deved9/Sat_beacon/BOM.ods

BOM
 |  |  |  | TOTAL: | 1010.757
CAPACITOR
val | Qty | link | price per one |  | total
100n | 25 | https://www.tme.eu/cz/details/0603b104k250ct/kondenzatory-mlcc-smd/walsin/ | 0.295 |  | 7.375 |  | Pro zápis do online tabulky:
4.7u | 27 | https://www.tme.eu/cz/details/cl21b475kafnnne/kondenzatory-mlcc-smd/samsung/ | 1.85 |  | 49.95
2.2u | 6 | https://www.tme.eu/cz/details/grm188r61e225ka12d/kondenzatory-mlcc-smd/murata/ | 0.737 |  | 4.422
10u | 10 | https://www.tme.eu/cz/details/grm188r61e106ka73d/kondenzatory-mlcc-smd/murata/ | 1.186 |  | 11.86 | C 100n | https://www.tme.eu/cz/details/0603b104k250ct/kondenzatory-mlcc-smd/walsin/ | 0,295 | 25 | Maňásek | Wed 8:00 | Mám k dispozici CSV soubory jak na Digikey tak TME. Můžu dodat pro ulehčení
22u | 6 | https://www.tme.eu/cz/details/cl21a226maynnne/kondenzatory-mlcc-smd/samsung/ | 1.417 |  | 8.502 | C 4.7u | https://www.tme.eu/cz/details/cl21b475kafnnne/kondenzatory-mlcc-smd/samsung/ | 1,85 | 27 | Maňásek | Wed 8:00
5.6n | 4 | https://www.digikey.cz/cs/products/detail/murata-electronics/GRT1885C1E562JA02D/10705377 | 2.03 |  | 8.12 | C 2.2u | https://www.tme.eu/cz/details/grm188r61e225ka12d/kondenzatory-mlcc-smd/murata/ | 0,737 | 6 | Maňásek | Wed 8:00
33n | 4 | https://www.tme.eu/cz/details/c0603c333k3rac/kondenzatory-mlcc-smd/kemet/c0603c333k3ractu/ | 1.25 |  | 5 | C 10u | https://www.tme.eu/cz/details/grm188r61e106ka73d/kondenzatory-mlcc-smd/murata/ | 1,186 | 10 | Maňásek | Wed 8:00
47p | 10 | https://www.tme.eu/cz/details/gjm1555c1h470jb01d/kondenzatory-mlcc-smd/murata/ | 1.017 |  | 10.17 | C 22u | https://www.tme.eu/cz/details/cl21a226maynnne/kondenzatory-mlcc-smd/samsung/ | 1,417 | 6 | Maňásek | Wed 8:00
13p | 10 | https://www.tme.eu/cz/details/gjm1555c1h130gb01d/kondenzatory-mlcc-smd/murata/ | 1.064 |  | 10.64 | C 5.6n | https://www.digikey.cz/cs/products/detail/murata-electronics/GRT1885C1E562JA02D/10705377 | 2,03 | 4 | Maňásek | Wed 8:00
 |  |  |  |  |  | C 33n | https://www.tme.eu/cz/details/c0603c333k3rac/kondenzatory-mlcc-smd/kemet/c0603c333k3ractu/ | 1,25 | 4 | Maňásek | Wed 8:00
LED |  |  |  |  |  | C 47p | https://www.tme.eu/cz/details/gjm1555c1h470jb01d/kondenzatory-mlcc-smd/murata/ | 1,017 | 10 | Maňásek | Wed 8:00
green | 6 | https://www.tme.eu/cz/details/rf-tgb190ts-ca-p1/diody-led-smd-barevne/refond/ | 2.54 |  | 15.24 | C 13p | https://www.tme.eu/cz/details/gjm1555c1h130gb01d/kondenzatory-mlcc-smd/murata/ | 1,064 | 10 | Maňásek | Wed 8:00
 |  |  |  |  |  | green LED | https://www.tme.eu/cz/details/rf-tgb190ts-ca-p1/diody-led-smd-barevne/refond/ | 2,54 | 6 | Maňásek | Wed 8:00
PLL |  |  |  |  |  | PLL LMX2581 | https://www.digikey.cz/cs/products/detail/texas-instruments/LMX2581SQE-NOPB/3727320 | 335,93 | 2 | Maňásek | Wed 8:00
LMX2581 | 2 | https://www.digikey.cz/cs/products/detail/texas-instruments/LMX2581SQE-NOPB/3727320 | 335.93 |  | 671.86 | L 18n | https://www.tme.eu/cz/details/lqg18hn18nj00d/tlumivky/murata/ | 2,59 | 6 | Maňásek | Wed 8:00
 |  |  |  |  |  | NPN BC817-40 | https://www.digikey.cz/cs/products/detail/diotec-semiconductor/BC817-40/13163902 | 2,84 | 10 | Maňásek | Wed 8:00
Inductor |  |  |  |  |  | R 1k | https://www.tme.eu/cz/details/rc0603fr-071k/rezistory-smd/yageo/rc0603fr-071kl/ | 0,46 | 10 | Maňásek | Wed 8:00
18n | 6 | https://www.tme.eu/cz/details/lqg18hn18nj00d/tlumivky/murata/ | 2.59 |  | 15.54 | R 51R | https://www.tme.eu/cz/details/wr06x51r0ftl/rezistory-smd/walsin/ | 0,27 | 10 | Maňásek | Wed 8:00
 |  |  |  |  |  | R 560R – 1206 | https://www.tme.eu/cz/details/rc1206fr-07560r/rezistory-smd/yageo/rc1206fr-07560rl/ | 1,108 | 6 | Maňásek | Wed 8:00
NPN |  |  |  |  |  | R 220k | https://www.tme.eu/cz/details/rc0603fr-07220k/rezistory-smd/yageo/rc0603fr-07220kl/ | 0,145 | 10 | Maňásek | Wed 8:00
BC817-40 | 10 | https://www.digikey.cz/cs/products/detail/diotec-semiconductor/BC817-40/13163902 | 2.84 |  | 28.4 | R 560R – 0603 | https://www.tme.eu/cz/details/rc0603fr-07560r/rezistory-smd/yageo/rc0603fr-07560rl/ | 0,19 | 10 | Maňásek | Wed 8:00
 |  |  |  |  |  | R 0R | https://www.tme.eu/cz/details/rc0603jr-070r/rezistory-smd/yageo/rc0603jr-070rl/ | 0,46 | 10 | Maňásek | Wed 8:00
Resistor |  |  |  |  |  | BTN | https://www.tme.eu/cz/details/b3fs-1015/mikrospinace-tact/omron-electronic-components/ | 7,37 | 4 | Maňásek | Wed 8:00
1k | 10 | https://www.tme.eu/cz/details/rc0603fr-071k/rezistory-smd/yageo/rc0603fr-071kl/ | 0.46 |  | 4.6 | MCU STM32C011F6Px | https://www.digikey.cz/cs/products/detail/stmicroelectronics/STM32C011F6P6TR/18085144 | 18,48 | 1 | Maňásek | Wed 8:00
51R | 10 | https://www.tme.eu/cz/details/wr06x51r0ftl/rezistory-smd/walsin/ | 0.27 |  | 2.7 | LDO LD1117V33 | https://www.digikey.cz/cs/products/detail/stmicroelectronics/LD1117DT33CTR/585759 | 8,12 | 5 | Maňásek | Wed 8:00
560R – 1206 | 6 | https://www.tme.eu/cz/details/rc1206fr-07560r/rezistory-smd/yageo/rc1206fr-07560rl/ | 1.108 |  | 6.648 | Balun 1720BL15B0050002E | https://www.digikey.cz/cs/products/detail/johanson-technology-inc/1720BL15B0050001E/5980443 | 6,91 | 2 | Maňásek | Wed 8:00
220k | 10 | https://www.tme.eu/cz/details/rc0603fr-07220k/rezistory-smd/yageo/rc0603fr-07220kl/ | 0.145 |  | 1.45 | TCXO FT2MHUPM10.0-T1 | https://www.digikey.cz/cs/products/detail/fox-electronics/FT2MHUPM10-0-T1/22155822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 | 39,4 | 1 | Maňásek | Wed 8:00
560R – 0603 | 10 | https://www.tme.eu/cz/details/rc0603fr-07560r/rezistory-smd/yageo/rc0603fr-07560rl/ | 0.19 |  | 1.9
0R | 10 | https://www.tme.eu/cz/details/rc0603jr-070r/rezistory-smd/yageo/rc0603jr-070rl/ | 0.46 |  | 4.6 | RF LNA | https://www.digikey.cz/cs/products/detail/texas-instruments/TRF37D73IDSGR/6572565 | 28,03 | 2 | Maňásek | Wed 8:00 | Soukromý nákup dle předchozí domluvy
 |  |  |  |  |  | LNB Controller | https://www.digikey.cz/cs/products/detail/richtek-usa-inc/RT5047BFGSP/8573230 | 29,45 | 2 | Maňásek | Wed 8:00
SW/BTN
power sw | 1 | vezmu to v GME, nevleze se do rozpočtu + moc není co vybírat |  |  | 0
BTN | 4 | https://www.tme.eu/cz/details/b3fs-1015/mikrospinace-tact/omron-electronic-components/ | 7.37 |  | 29.48
MCU
STM32C011F6Px | 1 | https://www.digikey.cz/cs/products/detail/stmicroelectronics/STM32C011F6P6TR/18085144 | 18.48 |  | 18.48
LDO
LD1117V33 | 5 | https://www.digikey.cz/cs/products/detail/stmicroelectronics/LD1117DT33CTR/585759 | 8.12 |  | 40.6
Balun
1720BL15B0050002E | 2 | https://www.digikey.cz/cs/products/detail/johanson-technology-inc/1720BL15B0050001E/5980443 | 6.91 |  | 13.82
FT2MHUPM10.0-T1 | 1 | https://www.digikey.cz/cs/products/detail/fox-electronics/FT2MHUPM10-0-T1/22155822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 | 39.4 |  | 39.4
