deved9/Sat_beacon/Sat_beacon.kicad_pcb

## KiCad design Sat_beacon.kicad_pcb (2026-05-11)

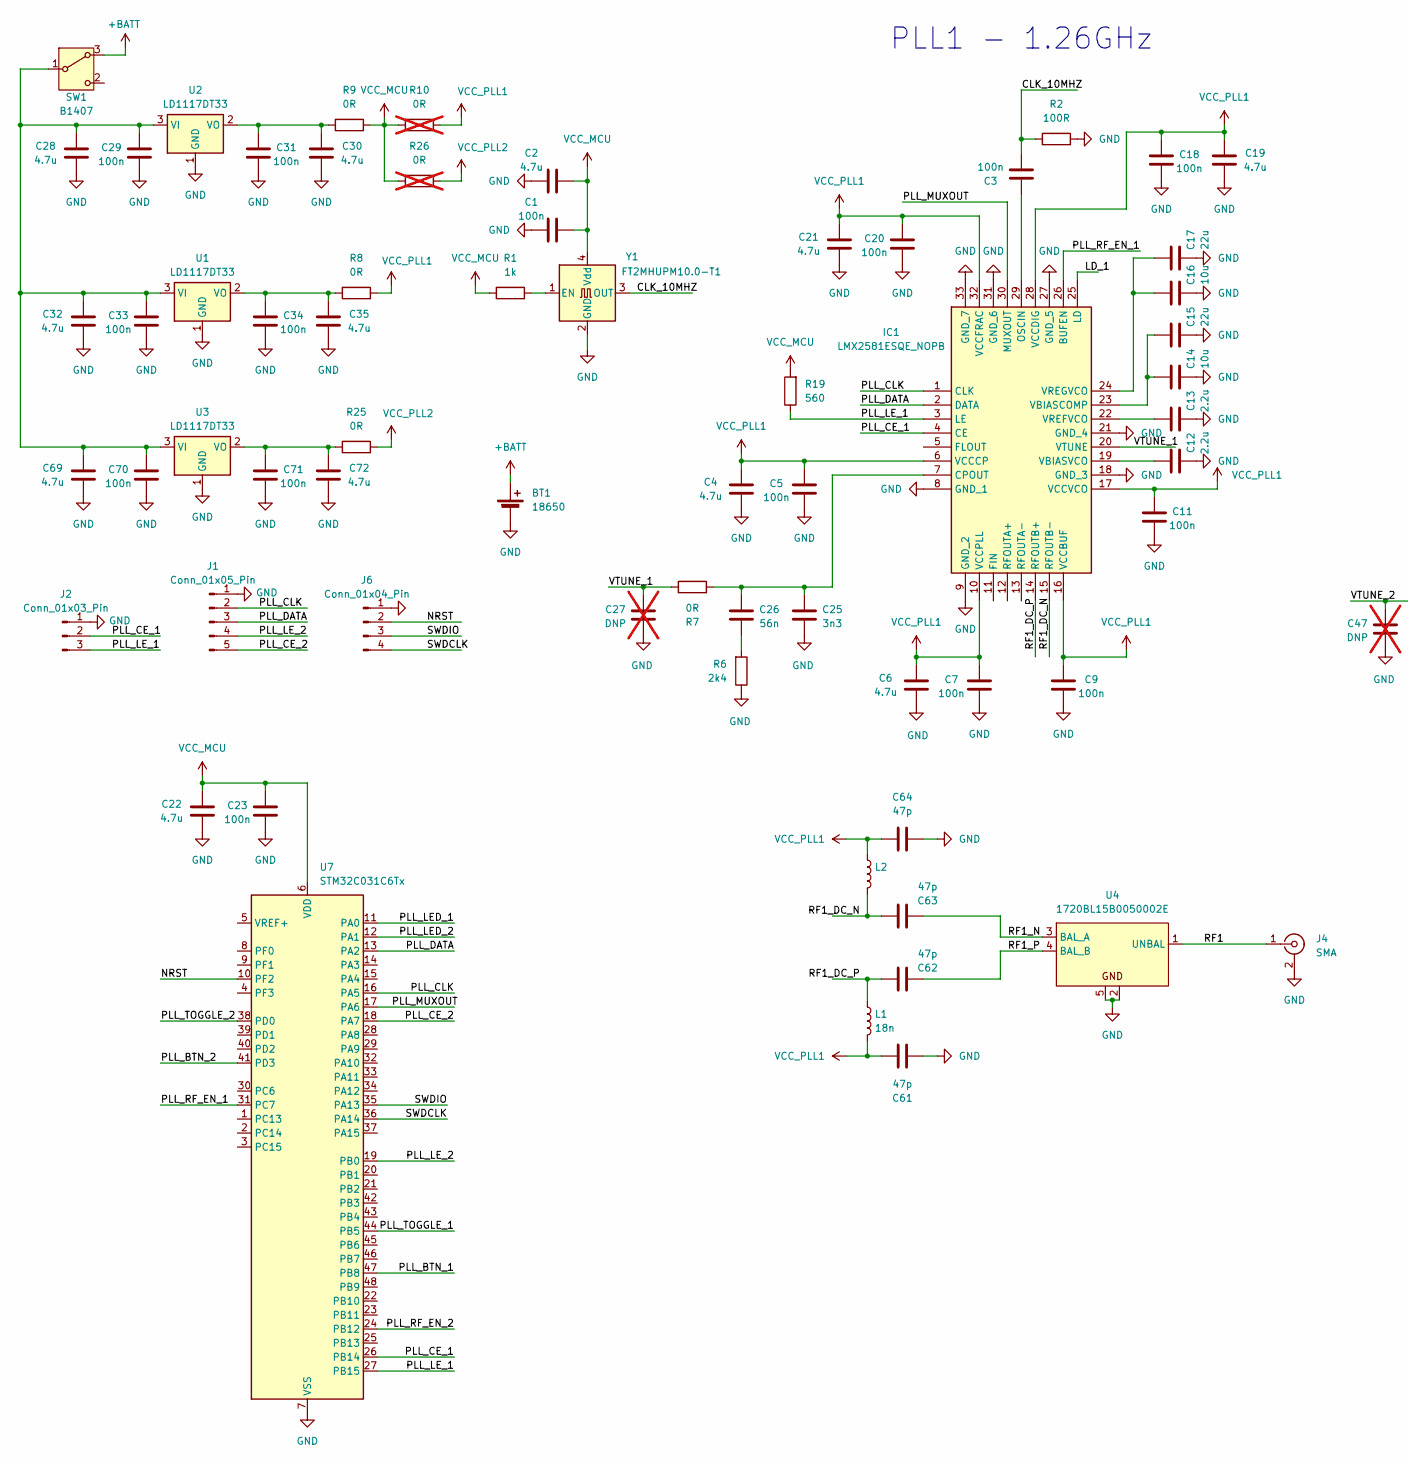
[picture p1: schematic Sat_beacon.kicad_sch, part in row 1, column 1]

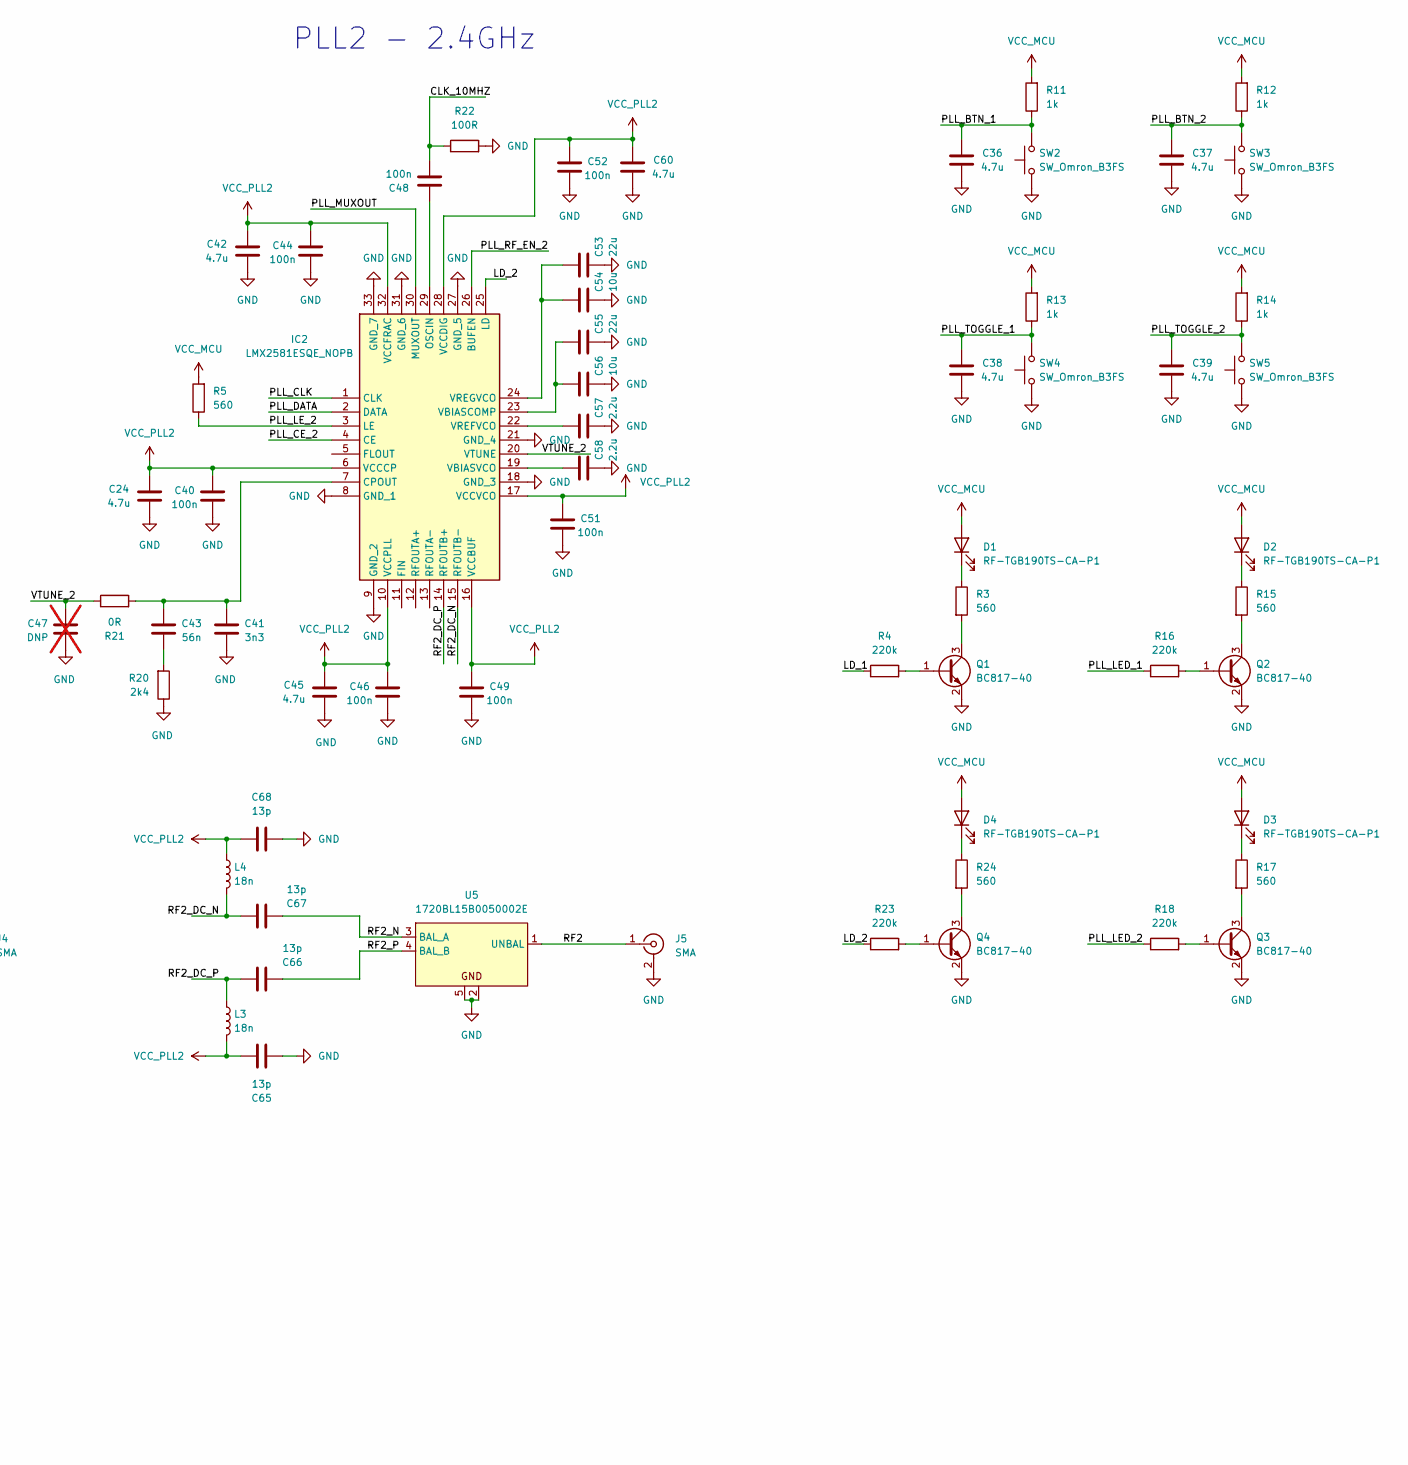
[picture p2: schematic Sat_beacon.kicad_sch, part in row 1, column 2]

Parts:
BT1: 18650; BatteryHolder_MPD_BH-18650-PC
C1, C3, C5, C7, C9, C11, C18, C20, C23, C29, C31, C33, C34, C40, C44, C46, C48, C49, C51, C52, C70, C71: 100n; C_0603_1608Metric
C2, C4, C6, C19, C21, C22, C24, C28, C30, C32, C35, C36, C37, C38, C39, C42, C45, C60, C69, C72: 4.7u; C_0805_2012Metric
C12, C13, C57, C58: 2.2u; C_0603_1608Metric
C14, C16, C54, C56: 10u; C_0603_1608Metric
C15, C17, C53, C55: 22u; C_0805_2012Metric
C25, C41: 3n3; C_0603_1608Metric
C26, C43: 56n; C_0603_1608Metric
C27, C47: DNP; C_0603_1608Metric; not fitted
C61, C62, C63, C64: 47p; C_0402_1005Metric
C65, C66, C67, C68: 13p; C_0402_1005Metric
D1, D2, D3, D4: RF-TGB190TS-CA-P1; LED_0603_1608Metric
IC1, IC2: LMX2581ESQE_NOPB; QFN50P500X500X80-33M; Mouser Part Number 595-LMX2581ESQE/NOPB
J1: Conn_01x05_Pin; PinHeader_1x05_P2.54mm_Vertical
J2: Conn_01x03_Pin; PinHeader_1x03_P2.54mm_Vertical
J4, J5: SMA; SMA_Amphenol_132289_EdgeMount
J6: Conn_01x04_Pin; PinHeader_1x04_P2.54mm_Vertical
L1, L2, L3, L4: 18n; L_0603_1608Metric
Q1, Q2, Q3, Q4: BC817-40; SOT-23
R1, R11, R12, R13, R14: 1k; R_0603_1608Metric
R2, R22: 100R; R_0805_2012Metric
R3, R15, R17, R24: 560; R_1206_3216Metric
R4, R16, R18, R23: 220k; R_0603_1608Metric
R5, R19: 560; R_0603_1608Metric
R6, R20: 2k4; R_0603_1608Metric
R7, R8, R9, R21, R25: 0R; R_0603_1608Metric
R10, R26: 0R; R_0603_1608Metric; not fitted
SW1: B1407; flip_switch
SW2, SW3, SW4, SW5: SW_Omron_B3FS; SW_SPST_Omron_B3FS-105xP
U1, U2, U3: LD1117DT33; TO-252-3_TabPin2
U4, U5: 1720BL15B0050002E; Balun_Johanson_0896BM15A0001
U7: STM32C031C6Tx; LQFP-48_7x7mm_P0.5mm
Y1: FT2MHUPM10.0-T1; Oscillator_SMD_SiT_PQFN-4Pin_2.5x2.0mm

Connections:
+BATT: BT1.1 (+), SW1.3 (A)
/CLK_10MHZ: C3.2, C48.2, R2.1, R22.1, Y1.3 (OUT)
/LD_1: IC1.25 (LD), R4.1
/LD_2: IC2.25 (LD), R23.1
/NRST: J6.2, U7.10 (PF2)
/PLL_BTN_1: C36.2, R11.1, SW2.2, U7.47 (PB8)
/PLL_BTN_2: C37.2, R12.1, SW3.2, U7.41 (PD3)
/PLL_CE_1: IC1.4 (CE), J2.2, U7.26 (PB14)
/PLL_CE_2: IC2.4 (CE), J1.5, U7.18 (PA7)
/PLL_CLK: IC1.1 (CLK), IC2.1 (CLK), J1.2, U7.16 (PA5)
/PLL_DATA: IC1.2 (DATA), IC2.2 (DATA), J1.3, U7.13 (PA2)
/PLL_LED_1: R16.1, U7.11 (PA0)
/PLL_LED_2: R18.1, U7.12 (PA1)
/PLL_LE_1: IC1.3 (LE), J2.3, R19.1, U7.27 (PB15)
/PLL_LE_2: IC2.3 (LE), J1.4, R5.1, U7.19 (PB0)
/PLL_RF_EN_1: IC1.26 (BUFEN), U7.31 (PC7)
/PLL_RF_EN_2: IC2.26 (BUFEN), U7.24 (PB12)
/PLL_TOGGLE_1: C38.2, R13.1, SW4.2, U7.44 (PB5)
/PLL_TOGGLE_2: C39.2, R14.1, SW5.2, U7.38 (PD0)
/RF1: J4.1 (In), U4.1 (UNBAL)
/RF1_DC_N: C63.1, IC1.15 (RFOUTB-), L2.2
/RF1_DC_P: C62.1, IC1.14 (RFOUTB+), L1.1
/RF1_N: C63.2, U4.3 (BAL_A)
/RF1_P: C62.2, U4.4 (BAL_B)
/RF2: J5.1 (In), U5.1 (UNBAL)
/RF2_DC_N: C67.1, IC2.15 (RFOUTB-), L4.2
/RF2_DC_P: C66.1, IC2.14 (RFOUTB+), L3.1
/RF2_N: C67.2, U5.3 (BAL_A)
/RF2_P: C66.2, U5.4 (BAL_B)
/SWDCLK: J6.4, U7.36 (PA14)
/SWDIO: J6.3, U7.35 (PA13)
/VTUNE_1: C27.2, IC1.20 (VTUNE), R7.1
/VTUNE_2: C47.2, IC2.20 (VTUNE), R21.1
GND: BT1.2 (-), C1.1, C2.1, C4.1, C5.1, C6.1, C7.1, C9.1, C11.1, C12.1, C13.1, C14.1, C15.1, C16.1, C17.1, C18.1, C19.1, C20.1, C21.1, C22.1, C23.1, C24.1, C25.1, C27.1, C28.1, C29.1, C30.1, C31.1, C32.1, C33.1, C34.1, C35.1, C36.1, C37.1, C38.1, C39.1, C40.1, C41.1, C42.1, C44.1, C45.1, C46.1, C47.1, C49.1, C51.1, C52.1, C53.1, C54.1, C55.1, C56.1, C57.1, C58.1, C60.1, C61.2, C64.2, C65.2, C68.2, C69.1, C70.1, C71.1, C72.1, IC1.8 (GND_1), IC1.9 (GND_2), IC1.18 (GND_3), IC1.21 (GND_4), IC1.27 (GND_5), IC1.31 (GND_6), IC1.33 (GND_7), IC2.8 (GND_1), IC2.9 (GND_2), IC2.18 (GND_3), IC2.21 (GND_4), IC2.27 (GND_5), IC2.31 (GND_6), IC2.33 (GND_7), J1.1, J2.1, J4.2 (Ext), J5.2 (Ext), J6.1, Q1.2 (E), Q2.2 (E), Q3.2 (E), Q4.2 (E), R2.2, R6.1, R20.1, R22.2, SW2.1, SW3.1, SW4.1, SW5.1, U1.1 (GND), U2.1 (GND), U3.1 (GND), U4.2, U4.5, U5.2, U5.5, U7.7 (VSS), Y1.2 (GND)
unnamed: C26.1, R6.2
unnamed: C43.1, R20.2
unnamed: D1.1 (K), R3.1
unnamed: D2.1 (K), R15.1
unnamed: D3.1 (K), R17.1
unnamed: D4.1 (K), R24.1
unnamed: C25.2, C26.2, IC1.7 (CPOUT), R7.2
unnamed: C3.1, IC1.29 (OSCIN)
unnamed: C14.2, C15.2, IC1.23 (VBIASCOMP)
unnamed: C12.2, IC1.19 (VBIASVCO)
unnamed: C13.2, IC1.22 (VREFVCO)
unnamed: C16.2, C17.2, IC1.24 (VREGVCO)
unnamed: C41.2, C43.2, IC2.7 (CPOUT), R21.2
unnamed: C48.1, IC2.29 (OSCIN)
unnamed: C55.2, C56.2, IC2.23 (VBIASCOMP)
unnamed: C58.2, IC2.19 (VBIASVCO)
unnamed: C57.2, IC2.22 (VREFVCO)
unnamed: C53.2, C54.2, IC2.24 (VREGVCO)
unnamed: Q1.1 (B), R4.2
unnamed: Q1.3 (C), R3.2
unnamed: Q2.1 (B), R16.2
unnamed: Q2.3 (C), R15.2
unnamed: Q3.1 (B), R18.2
unnamed: Q3.3 (C), R17.2
unnamed: Q4.1 (B), R23.2
unnamed: Q4.3 (C), R24.2
unnamed: C28.2, C29.2, C32.2, C33.2, C69.2, C70.2, SW1.1 (B), U1.3 (VI), U2.3 (VI), U3.3 (VI)
unnamed: C34.2, C35.2, R8.2, U1.2 (VO)
unnamed: C30.2, C31.2, R9.2, U2.2 (VO)
unnamed: C71.2, C72.2, R25.2, U3.2 (VO)
unnamed: R1.2, Y1.1 (EN)
VCC_MCU: C1.2, C2.2, C22.2, C23.2, D1.2 (A), D2.2 (A), D3.2 (A), D4.2 (A), R1.1, R5.2, R9.1, R10.2, R11.2, R12.2, R13.2, R14.2, R19.2, R26.2, U7.6 (VDD), Y1.4 (Vdd)
VCC_PLL1: C4.2, C5.2, C6.2, C7.2, C9.2, C11.2, C18.2, C19.2, C20.2, C21.2, C61.1, C64.1, IC1.6 (VCCCP), IC1.10 (VCCPLL), IC1.16 (VCCBUF), IC1.17 (VCCVCO), IC1.28 (VCCDIG), IC1.32 (VCCFRAC), L1.2, L2.1, R8.1, R10.1
VCC_PLL2: C24.2, C40.2, C42.2, C44.2, C45.2, C46.2, C49.2, C51.2, C52.2, C60.2, C65.1, C68.1, IC2.6 (VCCCP), IC2.10 (VCCPLL), IC2.16 (VCCBUF), IC2.17 (VCCVCO), IC2.28 (VCCDIG), IC2.32 (VCCFRAC), L3.2, L4.1, R25.1, R26.1

Notes on the sheet:
PLL2 - 2.4GHz
PLL1 - 1.26GHz

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
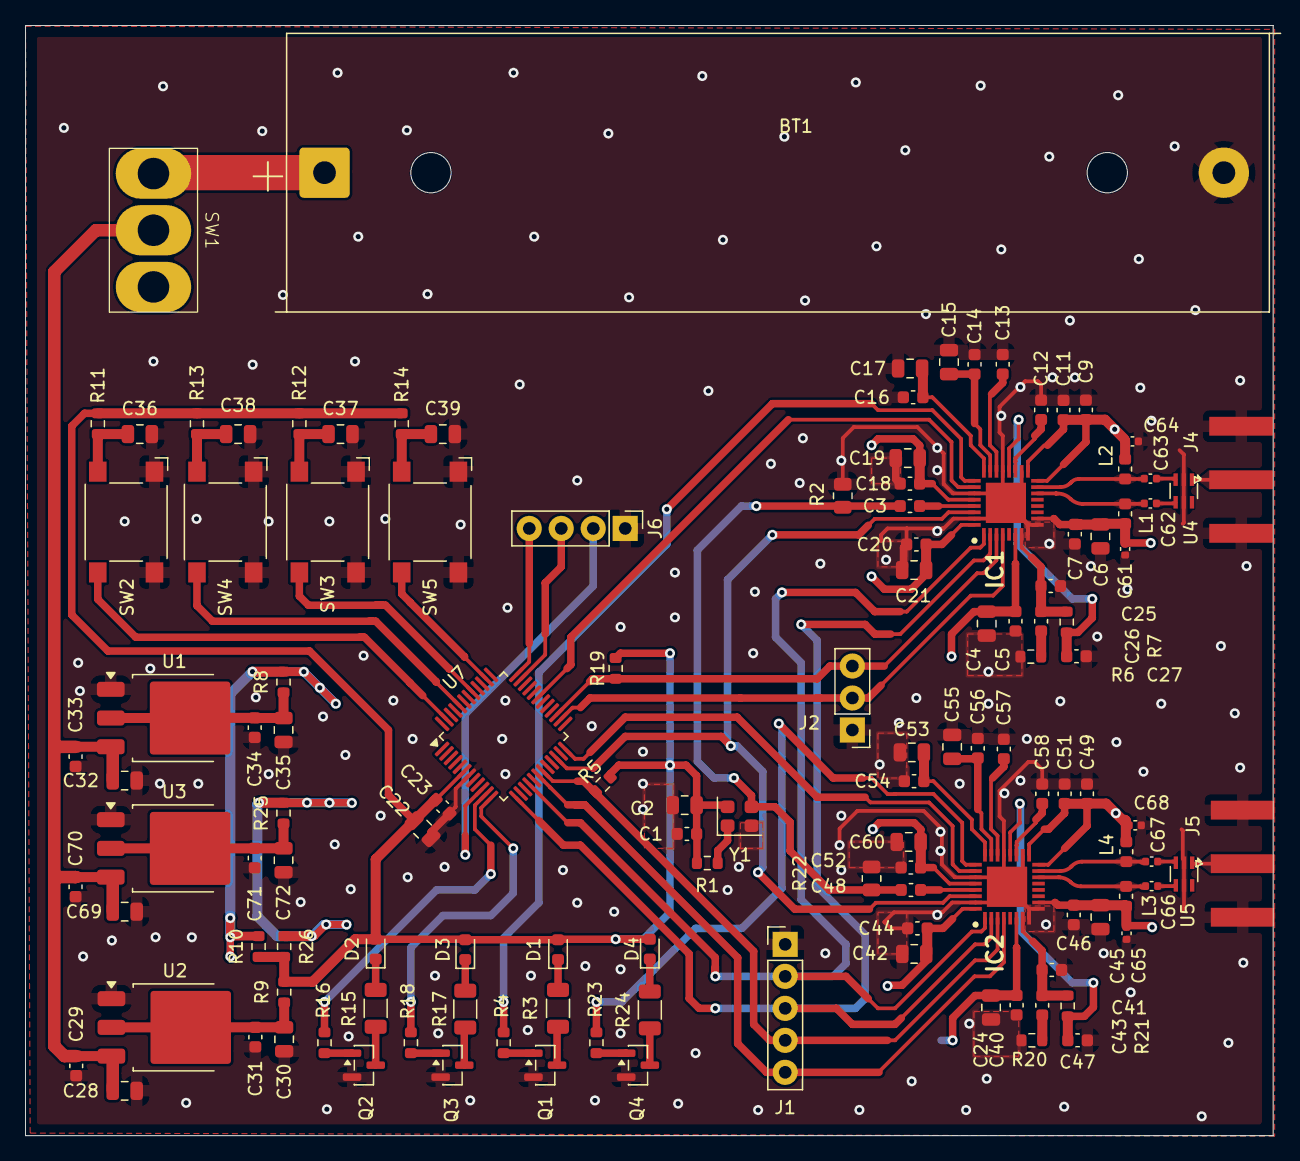
[picture p3: board Sat_beacon.kicad_pcb from above]

Board: 4 copper layers, 99.1 x 88.1 mm, 126 parts (0 on the bottom side), 69 nets.
