deved9/Sat_beacon/Software/Core/Src/main.c

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
/* Includes ------------------------------------------------------------------*/
#include "main.h"

/* USER CODE BEGIN Includes */
#include "LMX2581.h"
/* USER CODE END Includes */


void SystemClock_Config(void);
static void MX_GPIO_Init(void);
static void MX_SPI1_Init(void);
/**
  * @brief  The application entry point.
  * @retval int
  */
int main(void)
{

  /* MCU Configuration--------------------------------------------------------*/

  /* Reset of all peripherals, Initializes the Flash interface and the Systick. */
  LL_APB2_GRP1_EnableClock(LL_APB2_GRP1_PERIPH_SYSCFG);
  LL_APB1_GRP1_EnableClock(LL_APB1_GRP1_PERIPH_PWR);

  /* SysTick_IRQn interrupt configuration */
  NVIC_SetPriority(SysTick_IRQn, 3);

  /* Configure the system clock */
  SystemClock_Config();

  /* Initialize all configured peripherals */
  MX_GPIO_Init();
  MX_SPI1_Init();
  /* USER CODE BEGIN 2 */
  //SystemCoreClockUpdate();
  //LL_Init1msTick(SystemCoreClock);

  // LED TEST
  //while ((PLL_BTN_1_GPIO_Port->IDR & PLL_BTN_1_Pin)) {}


  //while ((PLL_BTN_2_GPIO_Port->IDR & PLL_BTN_2_Pin)) {}


  //while ((PLL_TOGGLE_1_GPIO_Port->IDR & PLL_TOGGLE_1_Pin)) {}
  //while ((PLL_TOGGLE_2_GPIO_Port->IDR & PLL_TOGGLE_2_Pin)) {}

  //LL_GPIO_SetOutputPin(PLL_LED_1_GPIO_Port, PLL_LED_1_Pin);
  //LL_GPIO_SetOutputPin(PLL_LED_2_GPIO_Port, PLL_LED_2_Pin);

  PLL_t PLL_high = PLL_init(PLL_CE_1_GPIO_Port, PLL_CE_1_Pin, PLL_LE_1_GPIO_Port, PLL_LE_1_Pin, 2400, 0, 0, 0, 0);
  PLL_write_reg(&PLL_high, SPI1);
  PLL_t PLL_low = PLL_init(PLL_CE_2_GPIO_Port, PLL_CE_2_Pin, PLL_LE_2_GPIO_Port, PLL_LE_2_Pin, 2520, 0, 0, 1, 0);
  PLL_write_reg(&PLL_low, SPI1);

  uint8_t RF_1_out = 0;
  uint8_t RF_1_out_prev = 0;
  uint8_t BTN_1_curr = 0;
  uint8_t BTN_1_prev = 0;
  uint8_t TOGGLE_1_curr = 0;
  uint8_t TOGGLE_1_prev = 0;
  uint8_t TOGGLE_1_en = 0;

  uint8_t RF_2_out = 0;
  uint8_t RF_2_out_prev = 0;
  uint8_t BTN_2_curr = 0;
  uint8_t BTN_2_prev = 0;
  uint8_t TOGGLE_2_curr = 0;
  uint8_t TOGGLE_2_prev = 0;
  uint8_t TOGGLE_2_en = 0;
  /* USER CODE END 2 */

  /* Infinite loop */
  /* USER CODE BEGIN WHILE */
  while (1)
  {
  	BTN_1_curr = !(PLL_BTN_1_GPIO_Port->IDR & PLL_BTN_1_Pin);
  	TOGGLE_1_curr = !(PLL_TOGGLE_1_GPIO_Port->IDR & PLL_TOGGLE_1_Pin);
  	BTN_2_curr = !(PLL_BTN_2_GPIO_Port->IDR & PLL_BTN_2_Pin);
  	TOGGLE_2_curr = !(PLL_TOGGLE_2_GPIO_Port->IDR & PLL_TOGGLE_2_Pin);

  	compare_toggle(TOGGLE_1_curr, TOGGLE_1_prev, &RF_1_out, &TOGGLE_1_en);
  	compare_toggle(TOGGLE_2_curr, TOGGLE_2_prev, &RF_2_out, &TOGGLE_2_en);

    compare_btn(BTN_1_curr, BTN_1_prev, &RF_1_out, &TOGGLE_1_en);
    compare_btn(BTN_2_curr, BTN_2_prev, &RF_2_out, &TOGGLE_2_en);

    output_logic(PLL_RF_EN_1_GPIO_Port, PLL_RF_EN_1_Pin, PLL_LED_1_GPIO_Port, PLL_LED_1_Pin, RF_1_out, &RF_1_out_prev);
    output_logic(PLL_RF_EN_2_GPIO_Port, PLL_RF_EN_2_Pin, PLL_LED_2_GPIO_Port, PLL_LED_2_Pin, RF_2_out, &RF_2_out_prev);

    BTN_1_prev = BTN_1_curr;
  	BTN_2_prev = BTN_2_curr;

  	TOGGLE_1_prev = TOGGLE_1_curr;
  	TOGGLE_2_prev = TOGGLE_2_curr;

    /* USER CODE END WHILE */

    /* USER CODE BEGIN 3 */
  }
  /* USER CODE END 3 */
}

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
/* USER CODE BEGIN 4 */
void compare_toggle(uint8_t current, uint8_t previous, uint8_t* RF_out, uint8_t* TOGGLE_en) {
  if (current > previous) {
    (*RF_out) = !(*RF_out);
  	(*TOGGLE_en) = !(*TOGGLE_en);
  }
}

void compare_btn(uint8_t current, uint8_t previous, uint8_t* RF_out, uint8_t* TOGGLE_en) {
  if (!(*TOGGLE_en)) {
    if (current > previous) {
  	  (*RF_out) = 1;
  	} else if(current < previous){
  	 (*RF_out) = 0;
  	}
  }
}
void output_logic(GPIO_TypeDef* RF_en_port, uint32_t RF_en_pin, GPIO_TypeDef* LED_port, uint32_t LED_pin, uint8_t current, uint8_t* previous) {
	if (current > (*previous)) {
	  		RF_en_port->BSRR = RF_en_pin;
	  		LED_port->BSRR = LED_pin;
	  		(*previous) = current;
	} else if (current < (*previous)){
		RF_en_port->BRR = RF_en_pin;
		LED_port->BRR = LED_pin;
		(*previous) = current;
	}
}



/* USER CODE END 4 */
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
