deved9/Sat_beacon/Software/Core/Inc/main.h

#define PLL_LED_1_Pin LL_GPIO_PIN_0
#define PLL_LED_1_GPIO_Port GPIOA
#define PLL_LED_2_Pin LL_GPIO_PIN_1
#define PLL_LED_2_GPIO_Port GPIOA
#define PLL_DATA_Pin LL_GPIO_PIN_2
#define PLL_DATA_GPIO_Port GPIOA
#define PLL_CLK_Pin LL_GPIO_PIN_5
#define PLL_CLK_GPIO_Port GPIOA
#define PLL_CE_2_Pin LL_GPIO_PIN_7
#define PLL_CE_2_GPIO_Port GPIOA
#define PLL_LE_2_Pin LL_GPIO_PIN_0
#define PLL_LE_2_GPIO_Port GPIOB
#define PLL_RF_EN_2_Pin LL_GPIO_PIN_12
#define PLL_RF_EN_2_GPIO_Port GPIOB
#define PLL_CE_1_Pin LL_GPIO_PIN_14
#define PLL_CE_1_GPIO_Port GPIOB
#define PLL_LE_1_Pin LL_GPIO_PIN_15
#define PLL_LE_1_GPIO_Port GPIOB
#define PLL_RF_EN_1_Pin LL_GPIO_PIN_7
#define PLL_RF_EN_1_GPIO_Port GPIOC
#define PLL_MUXout_Pin LL_GPIO_PIN_11
#define PLL_MUXout_GPIO_Port GPIOA
#define PLL_TOGGLE_2_Pin LL_GPIO_PIN_0
#define PLL_TOGGLE_2_GPIO_Port GPIOD
#define PLL_BTN_2_Pin LL_GPIO_PIN_3
#define PLL_BTN_2_GPIO_Port GPIOD
#define PLL_TOGGLE_1_Pin LL_GPIO_PIN_5
#define PLL_TOGGLE_1_GPIO_Port GPIOB
#define PLL_BTN_1_Pin LL_GPIO_PIN_8
#define PLL_BTN_1_GPIO_Port GPIOB
#define NVIC_PRIORITYGROUP_0         ((uint32_t)0x00000007) /*!< 0 bit  for pre-emption priority,
#define NVIC_PRIORITYGROUP_1         ((uint32_t)0x00000006) /*!< 1 bit  for pre-emption priority,
#define NVIC_PRIORITYGROUP_2         ((uint32_t)0x00000005) /*!< 2 bits for pre-emption priority,
#define NVIC_PRIORITYGROUP_3         ((uint32_t)0x00000004) /*!< 3 bits for pre-emption priority,
#define NVIC_PRIORITYGROUP_4         ((uint32_t)0x00000003) /*!< 4 bits for pre-emption priority,
