deved9/Sat_beacon/(commit log)

2026-02-25 added pin headers + signal nets fixes
    [Sat_beacon.kicad_sch]
2026-02-26 MCU-to-PLL pins added. Software folder created
    [Sat_beacon.kicad_sch]
2026-02-26 picked LEDs and fixed resistors
    [Sat_beacon.kicad_sch]
2026-02-27 PLL_LE pullup added
    [Sat_beacon.kicad_sch]
2026-02-27 fixed PLL caps
    [Sat_beacon.kicad_sch]
2026-02-27 RF balun added
    [Sat_beacon.kicad_sch]
2026-03-01 PLL RF enable added
    [Sat_beacon.kicad_sch]
2026-03-01 Fixed VTUNE, added battery, power switch, RF caps, net labels
    [Sat_beacon.kicad_sch]
2026-03-02 RF C added, replacement needed
    [Sat_beacon.kicad_sch]
2026-03-02 footprint fixes, BOM and CSV generated
    [BOM.ods, Sat_beacon.kicad_sch, TME_SAT_beacon.csv, digikey_SAT_beacon.csv]
2026-03-02 Separated PLL power
    [Sat_beacon.kicad_sch]
2026-03-02 MMCX model added
    [Sat_beacon.kicad_sch]
2026-03-03 MCU swap, IOC created
    [Sat_beacon.kicad_sch]
2026-03-03 Group and place components on PCB, two PLL caps removed, swapped RF lines
    [Sat_beacon.kicad_pcb, Sat_beacon.kicad_sch, digikey_SAT_beacon.csv]
2026-03-06 PCB work
    [Sat_beacon.kicad_pcb]
2026-03-09 MUXout added, LEDs swapped (SCH only)
    [Sat_beacon.kicad_sch]
2026-03-11 NRST pin added
    [Sat_beacon.kicad_sch]
2026-03-12 PCB stackup and rules defined, some PCB work done
    [Sat_beacon.kicad_pcb, Sat_beacon.kicad_sch]
2026-03-20 SW: Switched to SPI
    [Sat_beacon.kicad_sch]
2026-03-21 PCB work + MCU pin moves
    [Sat_beacon.kicad_pcb, Sat_beacon.kicad_sch]
2026-03-23 PCB routed
    [Sat_beacon.kicad_pcb, Sat_beacon.kicad_sch]
2026-03-24 PCB RF section improvement
    [Sat_beacon.kicad_pcb]
2026-03-25 new branch for 4 layer board, PCB updated, MMCX -> SMA
    [Sat_beacon-B_Cu.gbr, Sat_beacon-B_Mask.gbr, Sat_beacon-B_Paste.gbr, Sat_beacon-B_Silkscreen.gbr, Sat_beacon-Edge_Cuts.gbr, Sat_beacon-F_Cu.gbr, Sat_beacon-F_Mask.gbr, Sat_beacon-F_Paste.gbr]
2026-03-26 PCB improvements
    [Sat_beacon.kicad_pcb]
2026-03-26 PCB constrains updated for china + added vias, improved vias thanks to improved constrains
    [Sat_beacon.kicad_pcb]
2026-03-27 PCB done and ordered
    [Sat_beacon-B_Cu.gbr, Sat_beacon-B_Mask.gbr, Sat_beacon-B_Paste.gbr, Sat_beacon-B_Silkscreen.gbr, Sat_beacon-Edge_Cuts.gbr, Sat_beacon-F_Cu.gbr, Sat_beacon-F_Mask.gbr, Sat_beacon-F_Paste.gbr]
2026-04-28 fix schematic
    [Sat_beacon.kicad_sch]
2026-05-11 Modifications made while making it run + PLL filter design
    [Sat_beacon.kicad_pcb, Sat_beacon.kicad_sch]
